mrtbaggins95/SAWS/EAGLE_Stuff/LINK.txt

https://learn.adafruit.com/creating-accurate-footprints-in-eagle/importing-the-bitmap-into-eagle
