mrtbaggins95/SAWS/PCB Design/SAWS Peripheral Schematics_33A1F133-93B0-4803-9BBE-AD26970263C1-1.A.1/Released/SAWS Peripheral Schematics.PDF

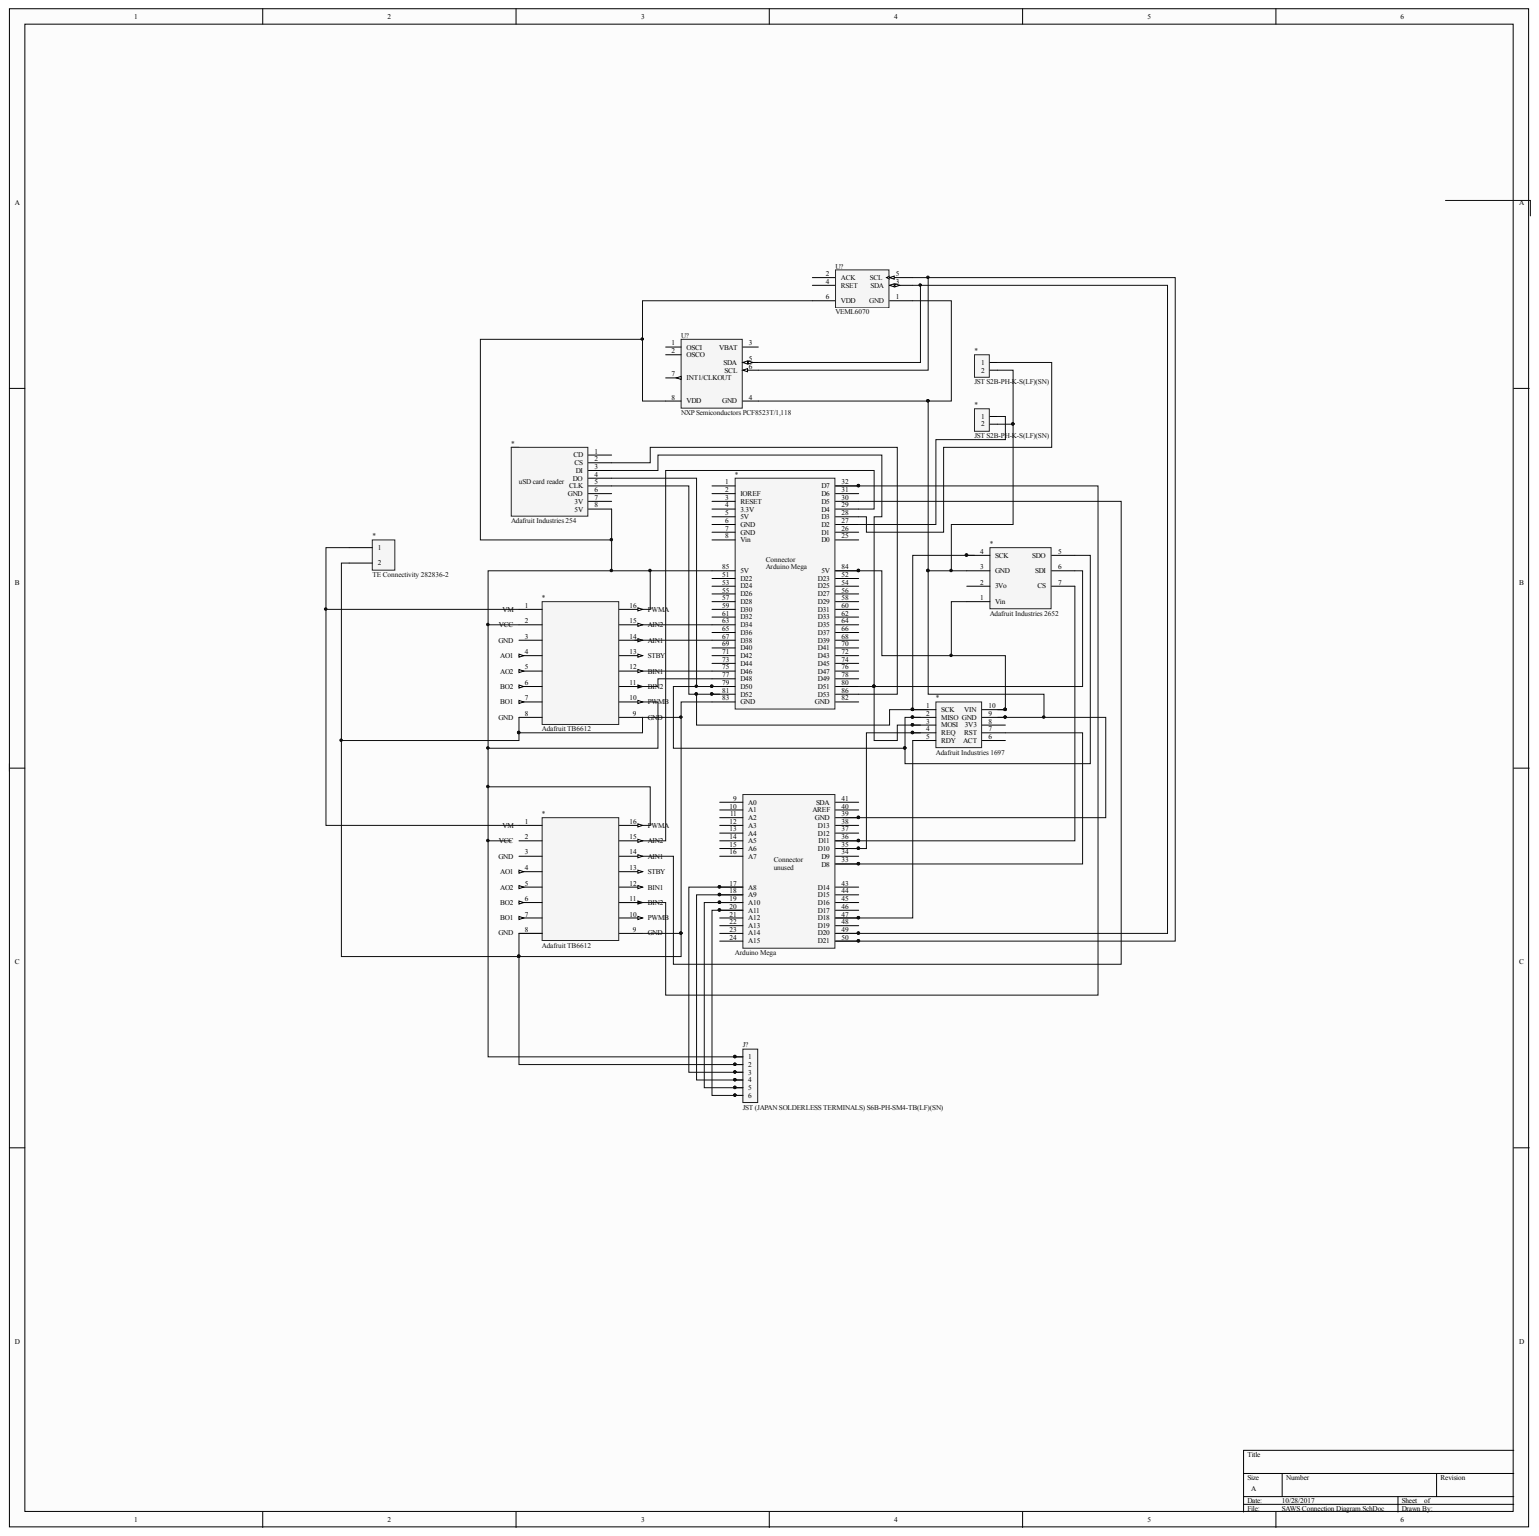
[picture p25: page 1]

PIU?04

VDD 6

GND 3

PI007 | | PI0010 | | | PI0082 | SCK 1

RDY 5 ACT MISO 2 | 6 RST 7 3V3 8 GND 9 VIN 10

PI002 | MOSI 3 | PI009

PI009 | | PI0041 | Adafruit Industries 1697

PI0010 | A1 10 | PI0040
PI0011 | A2 11 | PI0039

VCC | PI001 2 | PI0016 | AIN2 15 | PI0012 PI0012 PI0013 PI0013 | A4 13 | PI0038 PI0038 PI0037 PI0037

Size A | Number | Revision

Date: 10/28/2017 | Sheet of
File: SAWS Connection Diagram.SchDoc | Drawn By:

# Board S
