mrtbaggins95/SAWS/(list of files, drawings)

Other design files:
PCB Design/SAWS Peripheral Schematics_33A1F133-93B0-4803-9BBE-AD26970263C1-1.A.1/Design/SAWS Connection Diagram.SchDoc
PCB Design/SAWS Peripheral Schematics_33A1F133-93B0-4803-9BBE-AD26970263C1-1.A.1/Design/SAWS Peripheral Schematics.PrjPcb
