mrtbaggins95/SAWS/EAGLE_Stuff/Adafruit-PCF8523-RTC-Breakout-PCB-master/Adafruit PCF8523 RTC.brd

## EAGLE design EAGLE_Stuff/Adafruit-PCF8523-RTC-Breakout-PCB-master/Adafruit PCF8523 RTC.brd (2017-12-06)

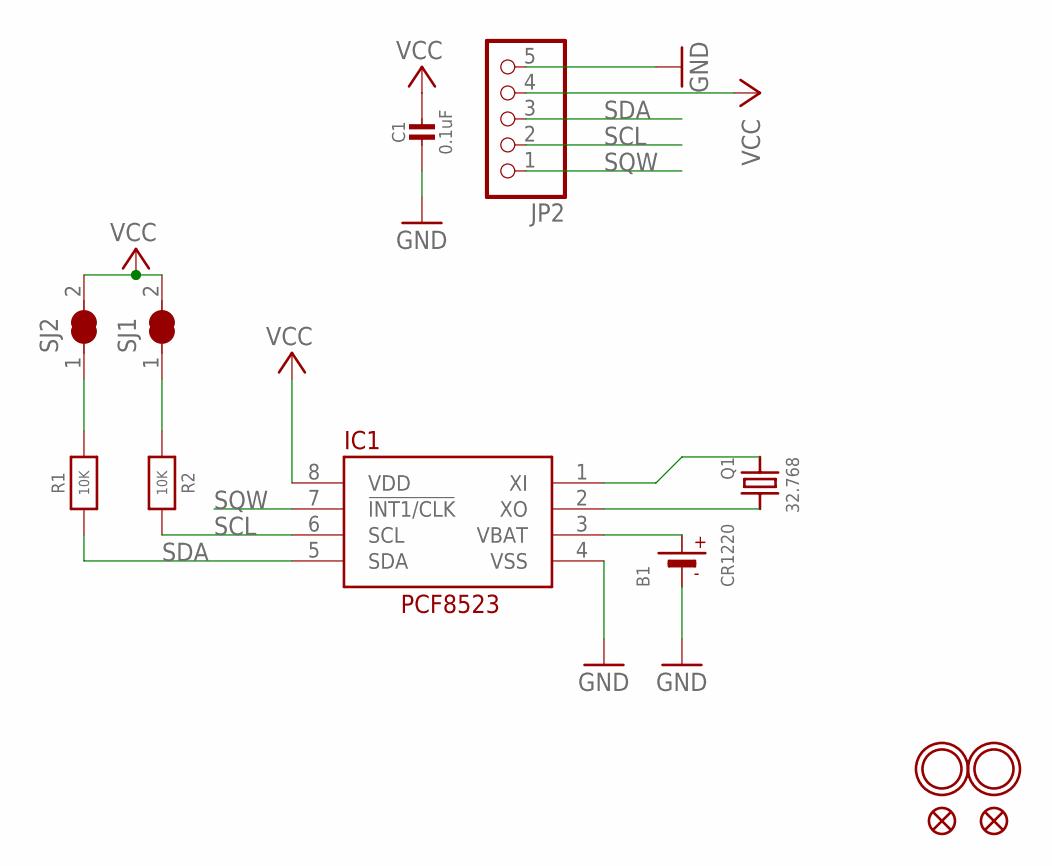
[picture p26: schematic Adafruit PCF8523 RTC.sch]

Parts:
B1: CR1220
C1: 0.1uF; 0805-NO
FID1, FID2: FIDUCIAL""; FIDUCIAL_1MM
IC1: RTC_PCF8523T; SOIC8_150MIL
JP2: HEADER-1X576MIL; 1X05_ROUND_76
Q1: 32.768; CRYSTAL_8X3.8
R1, R2: 10K; 0805-NO
SJ1, SJ2: SOLDERJUMPER_CLOSED; SOLDERJUMPER_CLOSEDWIRE
U$1, U$4: MOUNTINGHOLE2.0; MOUNTINGHOLE_2.0_PLATED

Connections:
GND: B1.-, C1.2, IC1.4 (VSS), JP2.5
unnamed: R2.1, SJ1.1
unnamed: R1.2, SJ2.1
unnamed: IC1.1 (XI), Q1.P$1 (1)
unnamed: IC1.2 (XO), Q1.P$4 (2)
SCL: IC1.6 (SCL), JP2.2, R2.2
SDA: IC1.5 (SDA), JP2.3, R1.1
SQW: IC1.7 (!INT1/CLK), JP2.1
VBAT: B1.+$1 (+), IC1.3 (VBAT)
VCC: C1.1, IC1.8 (VDD), JP2.4, SJ1.2, SJ2.2

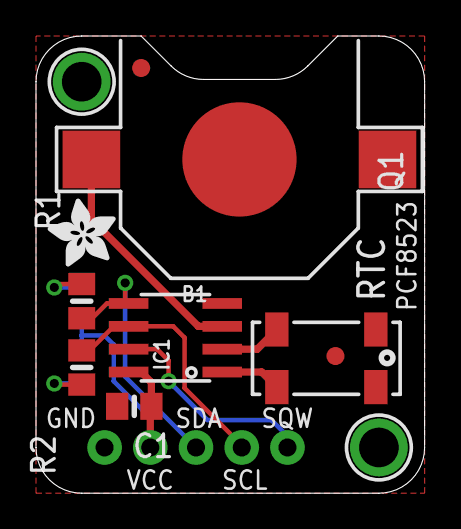
[picture p27: board Adafruit PCF8523 RTC.brd from above]

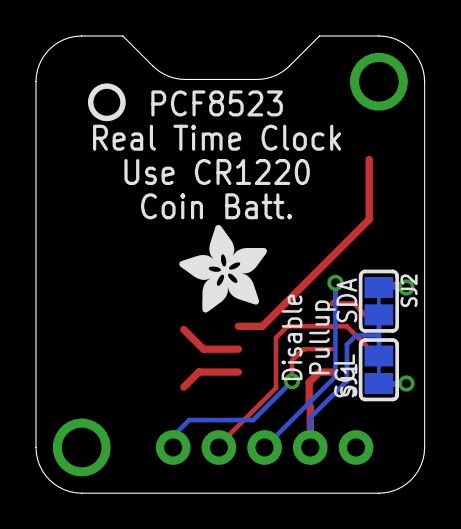
[picture p28: board Adafruit PCF8523 RTC.brd from below]

Board: 2 copper layers, 21.6 x 25.4 mm, 16 parts (4 on the bottom side), 10 nets.

Other parts of the board:
U$2: ADAFRUIT_3.5MM
U$3: PCBFEAT-REV-040
U$5: ADAFRUIT_5MM
