mrtbaggins95/SAWS/EAGLE_Stuff/Adafruit-Bluefruit-LE-nRF8001-PCB-master/Adafruit Bluefruit LE nRF8001.brd

## EAGLE design EAGLE_Stuff/Adafruit-Bluefruit-LE-nRF8001-PCB-master/Adafruit Bluefruit LE nRF8001.brd (2017-12-06)

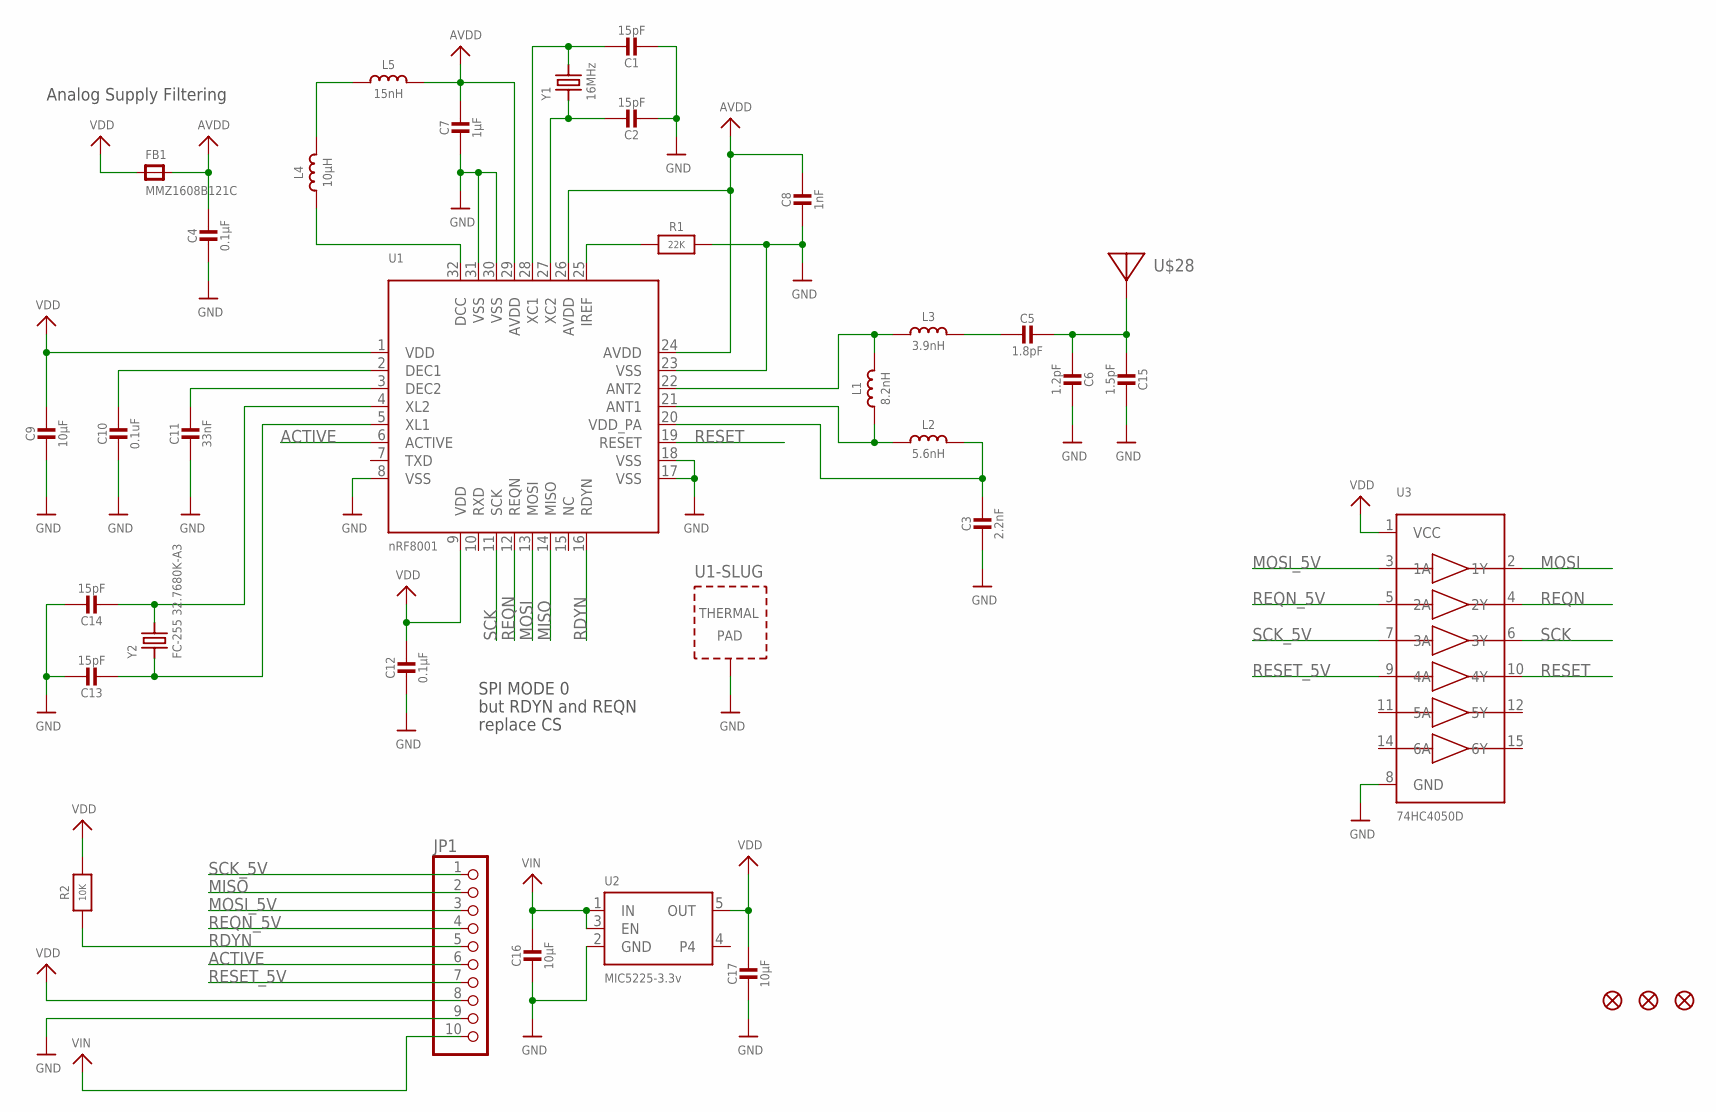
[picture p29: schematic Adafruit Bluefruit LE nRF8001.sch]

Parts:
C1, C2, C13, C14: 15pF; 0805-NO
C3: 2.2nF; _0402
C4, C12: 0.1µF; 0805-NO
C5: 1.8pF; _0402MP
C6: 1.2pF; _0402MP
C7: 1µF; 0805-NO
C8: 1nF; _0603
C9, C16, C17: 10µF; 0805-NO
C10: 0.1uF; 0805-NO
C11: 33nF; 0805-NO
C15: 1.5pF; _0402MP
FB1: MMZ1608B121C; 0805
FID1, FID2, FID3: FIDUCIAL""; FIDUCIAL_1MM
JP1: HEADER-1X1070MIL; 1X10_ROUND70
L1: 8.2nH; _0402
L2: 5.6nH; _0402
L3: 3.9nH; _0402
L4: 10µH; _0603
L5: 15nH; _0603
R1: 22K; _0805MP
R2: 10K; 0805-NO
U1: nRF8001; QFN32_5MM
U2: MIC5225-3.3v; SOT23-5
U3: 74HC4050D; TSSOP16
U$28: ANTENNA_PCBNRF8001_1.6MM; ANT_PCB_2.4GHZ_NRF8001_1.6MM_1OZ
Y1: 16MHz; CRYSTAL_2.5X2
Y2: FC-255 32.7680K-A3; CRYSTAL_4.9X1.8

Connections:
ACTIVE: JP1.6, U1.6 (ACTIVE)
AVDD: C4.1, C7.1, C8.1, FB1.2, L5.2, U1.24 (AVDD), U1.26 (AVDD), U1.29 (AVDD)
GND: C1.2, C2.2, C3.2, C4.2, C6.1, C7.2, C8.2, C9.2, C10.2, C11.2, C12.2, C13.1, C14.1, C15.1, C16.2, C17.2, JP1.9, R1.2, U1.8 (VSS), U1.17 (VSS), U1.18 (VSS), U1.23 (VSS), U1.30 (VSS), U1.31 (VSS), U1.33 (TP), U2.2 (GND), U3.8 (GND)
MISO: JP1.2, U1.14 (MISO)
MOSI: U1.13 (MOSI), U3.2 (1Y)
MOSI_5V: JP1.3, U3.3 (1A)
unnamed: L1.2, L3.1, U1.22 (ANT2)
unnamed: L1.1, L2.1, U1.21 (ANT1)
unnamed: C3.1, L2.2, U1.20 (VDD_PA)
unnamed: L4.2, L5.1
unnamed: C5.2, L3.2
unnamed: C11.1, U1.3 (DEC2)
unnamed: C10.1, U1.2 (DEC1)
unnamed: C1.1, U1.28 (XC1), Y1.3 (2)
unnamed: C2.1, U1.27 (XC2), Y1.1
unnamed: L4.1, U1.32 (DCC)
unnamed: R1.1, U1.25 (IREF)
unnamed: C5.1, C6.2, C15.2, U$28.FEED
unnamed: C14.2, U1.4 (XL2), Y2.2
unnamed: C13.2, U1.5 (XL1), Y2.1
RDYN: JP1.5, R2.1, U1.16 (RDYN)
REQN: U1.12 (REQN), U3.4 (2Y)
REQN_5V: JP1.4, U3.5 (2A)
RESET: U1.19 (RESET), U3.10 (4Y)
RESET_5V: JP1.7, U3.9 (4A)
SCK: U1.11 (SCK), U3.6 (3Y)
SCK_5V: JP1.1, U3.7 (3A)
VDD: C9.1, C12.1, C17.1, FB1.1, JP1.8, R2.2, U1.1 (VDD), U1.9 (VDD), U2.5 (OUT), U3.1 (VCC)
VIN: C16.1, JP1.10, U2.1 (IN), U2.3 (EN)

Notes on the sheet:
Analog Supply Filtering
SPI MODE 0
but RDYN and REQN
replace CS

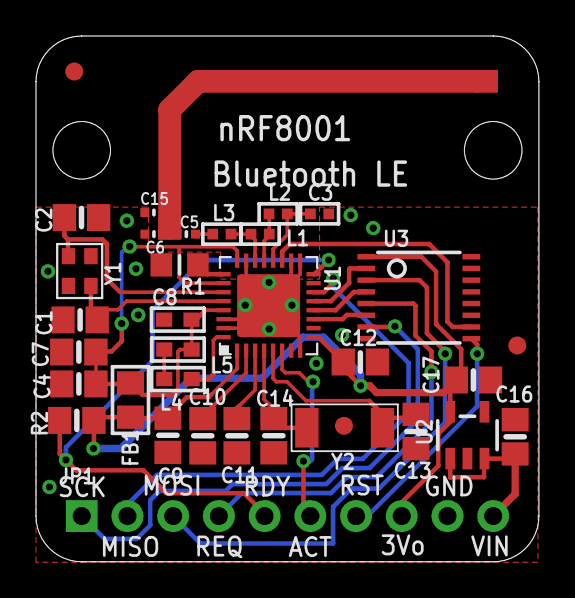
[picture p30: board Adafruit Bluefruit LE nRF8001.brd from above]

Board: 2 copper layers, 27.9 x 29.2 mm, 36 parts (1 on the bottom side), 29 nets.

Other parts of the board:
U$22: ADAFRUIT_TEXT_20MM
