mrtbaggins95/SAWS/EAGLE_Stuff/Adafruit-VEML6070-PCB-master/Adafruit VEML6070.brd

## EAGLE design EAGLE_Stuff/Adafruit-VEML6070-PCB-master/Adafruit VEML6070.brd (2017-12-06)

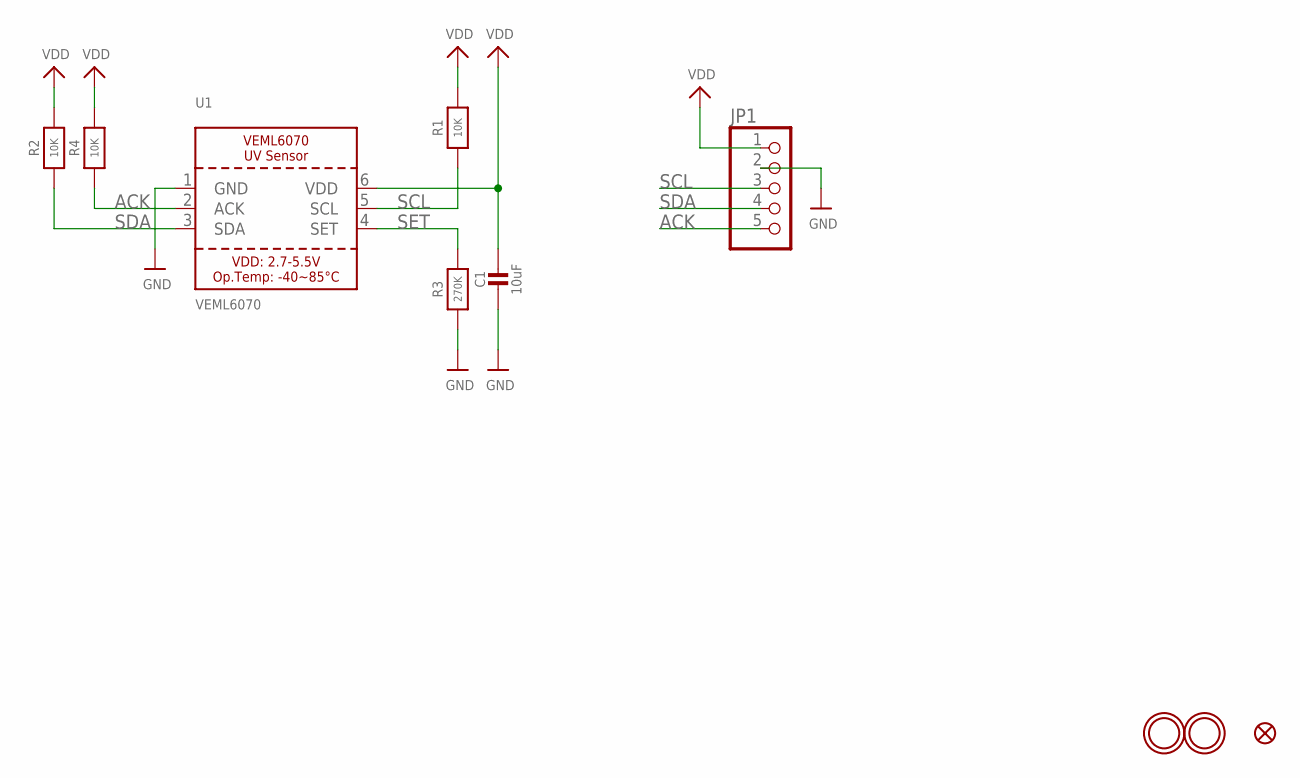
[picture p31: schematic Adafruit VEML6070.sch]

Parts:
C1: 10uF; 0805-NO
FID1: FIDUCIAL""; FIDUCIAL_1MM
JP1: HEADER-1X570MIL; 1X05_ROUND_70
R1, R2, R4: 10K; 0805-NO
R3: 270K; 0805-NO
U1: VEML6070
U$10, U$11: MOUNTINGHOLE2.5; MOUNTINGHOLE_2.5_PLATED

Connections:
ACK: JP1.5, R4.1, U1.2 (ACK)
GND: C1.2, JP1.2, R3.1, U1.1 (GND)
SCL: JP1.3, R1.1, U1.5 (SCL)
SDA: JP1.4, R2.1, U1.3 (SDA)
SET: R3.2, U1.4 (SET)
VDD: C1.1, JP1.1, R1.2, R2.2, R4.2, U1.6 (VDD)

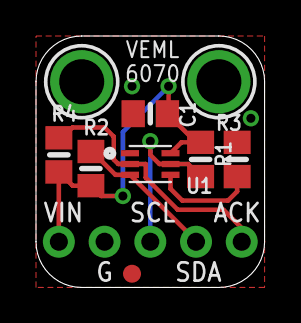
[picture p32: board Adafruit VEML6070.brd from above]

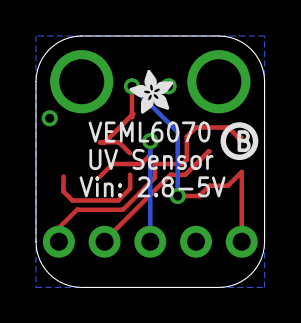
[picture p33: board Adafruit VEML6070.brd from below]

Board: 2 copper layers, 12.7 x 14.0 mm, 12 parts (2 on the bottom side), 6 nets.

Other parts of the board:
U$2: PCBFEAT-REV-040
U$14: ADAFRUIT_2.5MM
