mrtbaggins95/SAWS/EAGLE_Stuff/Adafruit-BMP280-Breakout-PCB-master/Adafruit BMP280.brd

## EAGLE design EAGLE_Stuff/Adafruit-BMP280-Breakout-PCB-master/Adafruit BMP280.brd (2017-12-06)


Parts:
C1, C3: 10uF; 0805-NO
D2: 1N4148; SOD-323
JP2: HEADER-1X770MIL; 1X07_ROUND_70
Q3, Q4: BSS138; SOT23-WIDE
R1, R2, R7, R8: 10K; 0805-NO
R4: 10K; _0805MP
U1: BME280
U2: MIC5225-3.3; SOT23-5
U$5, U$15: FIDUCIAL""; FIDUCIAL_1MM
U$7, U$8: MOUNTINGHOLE2.0; MOUNTINGHOLE_2.0_PLATED

Connections:
3.3V: C3.1, JP2.2, Q3.1 (G), Q4.1 (G), R1.2, R2.2, R4.2, U1.6 (VDDIO), U1.8 (VDD), U2.5 (OUT)
5.0V: C1.1, JP2.1, R7.2, R8.2, U2.1 (IN), U2.3 (EN)
CS_3V: D2.A, U1.2 (CSB)
CS_5V: D2.C, JP2.7
GND: C1.2, C3.2, JP2.3, U1.1 (GND), U1.7 (GND), U2.2 (GND)
SCK/SCL_5V: JP2.4, Q3.3 (D), R7.1
SCK_3V: Q3.2 (S), R2.1, U1.4 (SCK)
SDI/SDA_5V: JP2.6, Q4.3 (D), R8.1
SDI_3V: Q4.2 (S), R1.1, U1.3 (SDI)
SDO/ADR_3V: JP2.5, R4.1, U1.5 (SDO)

Notes on the sheet:
For SPI set CSB low at startup SDO=MISO, SDI=MOSI, SCK=SCK, CSB=CS/SSEL
For I2C leave CSB pulled high (default value) SDI=SDA, SCK=SCL
LEVEL SHIFTING (5V <--> 3V)

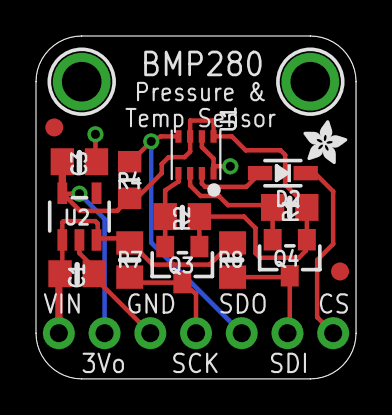
[picture p35: board Adafruit BMP280.brd from above]

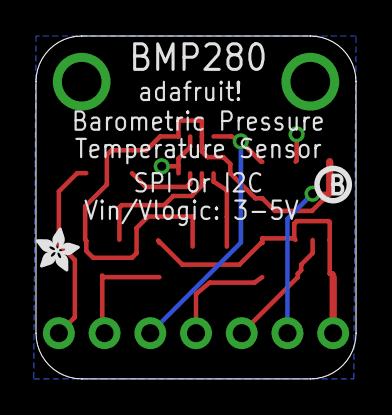
[picture p36: board Adafruit BMP280.brd from below]

Board: 2 copper layers, 17.8 x 19.1 mm, 20 parts (2 on the bottom side), 10 nets.

Other parts of the board:
U$2, U$6: ADAFRUIT_2.5MM
U$20: PCBFEAT-REV-040
