mrtbaggins95/SAWS/EAGLE_Stuff/MicroSD-breakout-board-master/microsd.brd

## EAGLE design EAGLE_Stuff/MicroSD-breakout-board-master/microsd.brd (2017-12-06)


Parts:
ACT: RED; CHIP-LED0805
C1: 10uF/10V; A/3216-18R
C2: 0.1uF; C0805K
IC1: 4050D; SO16
IC2: LP298XS; SOT23-5L
JP1: PINHD-1X8BIG; 1X08-BIG
R1: 1K; R0805
U$1, U$2: FIDUCIAL; FIDUCIAL_1MM
X1: MICROSD

Connections:
+3V3: C1.+, IC1.1 (VDD), IC2.5 (VOUT), JP1.2, X1.4 (VDD)
CD: JP1.8, X1.CD1 (CARD_DETECT)
CLK: IC1.3 (I), IC1.9 (I), JP1.4
CS: IC1.7 (I), JP1.7
DI: IC1.5 (I), JP1.6
DO: JP1.5, X1.7 (DATA_OUT)
GND: C1.-, C2.2, IC1.8 (VSS), IC1.11 (I), IC1.14 (I), IC2.2 (GND), JP1.3, X1.6 (VSS), X1.MT1 (GND), X1.MT2 (GND1)
unnamed: ACT.A, IC1.10 (O)
unnamed: IC1.2 (O), X1.5 (SCLK)
unnamed: IC1.6 (O), R1.1, X1.2 (CS)
unnamed: ACT.C, R1.2
unnamed: IC1.4 (O), X1.3 (DATA_IN)
VCC: C2.1, IC2.1 (VIN), IC2.3 (EN), JP1.1


Board: 2 copper layers, 31.8 x 25.4 mm, 10 parts (0 on the bottom side), 13 nets.
