mrtbaggins95/SAWS/HomeStepper_Test2/HomeStepper_Test2.ino

/* James Donahue
    10/22/17
    SAWS Fall 2017 Senior Design Project
    ***********************************************************
    THIS PROGRAM DEMONSTRATES HOME STEPPER AS WELL AS A FUNCTION TO MOVE THE SERVO TO A SPECIFIC ANGLE, WHILE UPDATING OUR ANGLE NUMBER
    This sketch demonstrates the use of a stepper home function. The program needs to keep track of the current position of the gantry.
    Since we are using bipolar stepper motors, we must calibrate the stepper position, with the virtual program position. 3D printers
    use home switches that close when the stepper motor hits a known position. This program uses interrupts to detect when the a normally open
    homing switch closes.
*/

int baseAngle;
#include <Stepper.h>
volatile int Home = false; // variable that is modified by the Interrupt, on pin 2. Needs to be global

void setup() {
  attachInterrupt(digitalPinToInterrupt(2), pin_ISR, LOW); // Defining an active low interrupt on the switch pin 2
  Serial.begin(9600);
  HomeStepper();
}

void loop() {
  if (Serial.available()) {
    int degree = Serial.parseInt();
    delay(10);
    if (degree < 0 || degree > 300) // limits set by machine
    {
      Serial.println(" Invalid Angle");
    }
    else
    {
      MoveStepper(degree); // function that moves stepper to a desired angle
    }

  }

  void HomeStepper() {
#define STBY 8 // Pull this pin low to completely cut off power to the stepper
#define STEPS 200 // Number of steps per rotation, this is specific to our motor
#define HomeSwitch 2
    Stepper stepper(STEPS, 4, 5, 6, 7); // creates a stepper object called stepper, using pins 4-7
    stepper.setSpeed(100); // sets the speed of the motor in rpm
    pinMode(STBY, OUTPUT);
    digitalWrite(STBY, HIGH);
    pinMode(HomeSwitch, INPUT_PULLUP); //sets the HomeSwitch pin(2) as an input that uses internall pull ups
    while (Home == false) { //This while loop continue to step the motor, while the swith is open(high)
      stepper.step(1); // steps the motor once
    }
    baseAngle = 0; // Now that we have homed, set the angle to zero.
    digitalWrite(STBY, LOW); // puts motor driver into standby
  }

  void pin_ISR() { // this is the interrupt service routine. Basically the function that happens when interrupt occurs
    Home = true; // update the home variable to exit the while loop.
  }

  void MoveStepper() {
    Stepper stepper(STEPS, 4, 5, 6, 7); // creates a stepper object called stepper, using pins 4-7
    stepper.setSpeed(100); // sets the speed of the motor in rpm
    float degPerStep = 1.8;
    int deltaSteps = (degree - baseAngle) / degPerStep;
    stepper.step(deltaSteps);
    baseAngle = degree; // update the virtual position variable after the stepper has moved
  }
