mrtbaggins95/SAWS/(commit log)

2017-10-07 Bluetooth and Sensor
    Attempted to transmit sensor serial monitor data to bluetooth
2017-10-08 bluetooth serial print
    interfaced the sensor data to print on the bluetooth connected device?
2017-10-09 Initial Commit
    Schematic includes traces between the Mega, BME280, and nrf80001.
    [SAWS Connection Diagram.SchDoc]
2017-10-17 Stepper adapted sweepSun
2017-10-21 Typo correction on SweepSun();
    [sweepSun_servo0.ino]
2017-10-22 This program demonstrates the use of the HomeStepper() function.
    HomeStepper only needs to be called once to function. This program contains two functions, HomeStepper() and pin_ISR(). pin_ISR() is an interrupt service routine. HOMESTEPPER USES INTERRUPTS BE CAREFULL WITH THIS. Both functions must be placed within the main program for this functionality to work. Also note that the stepper library must be included and that the variable Home must a globally define variable.
2017-10-23 coded base files for stepper commands
2017-10-23 Added Modulo correction to trackSun Stepper
    [HomeStepper_Test.ino, trackerSun_stepper.ino]
2017-10-28 Circuitmaker Schematic
    It's done
    [SAWS Connection Diagram.SchDoc]
2017-10-29 power results
    added the power components of our system. added a power flow diagram
    [BOM_PartType-SAWS Peripheral Schematics.xls, SAWS Connection Diagram.SchDoc, SAWS Peripheral Schematics.PrjPcb]
2017-11-01 added new slide for power results ppt
    included a new slide with pictures and included the measured readings from the panel
2017-11-01 power slides update
    updated power flow diagram to include bluetooth transceiver and the data storage
2017-11-29 11/29/17 update
    uploaded the library of the uv sensor
    uploaded the test code for uv sensor (still trying to figure out the ranges of the intensity reading)
    updated hub result presentation slides: the hub, issues encountered, solutions, and in progress
    [veml6070_test.ino]
2017-11-29 error free (so far) cpp and h for STA
    [sunFunctions.cpp]
2017-12-06 uv sensor code
    updated the code to output an UV index reading ie, Extreme, Very High, High, Moderate, Low
2017-12-06 CRAP
    CRAP from my attempts to use eagle.
    [Adafruit BMP280.brd, Adafruit BMP280.sch, Adafruit Bluefruit LE nRF8001 v2.brd, Adafruit Bluefruit LE nRF8001 v2.sch, Adafruit Bluefruit LE nRF8001.brd, Adafruit Bluefruit LE nRF8001.sch, Adafruit PCF8523 RTC.brd, Adafruit PCF8523 RTC.sch]
2017-12-07 uv sensor 12/6 update
    fixed the reading = uv.readUV declaration
    changed the print output from values to UV index
    [veml6070_test.ino]
2017-12-09 12/8-9/17 update
    incorporated UV sensor (VEML6070) to the BLE-BME code
2017-12-10 new BLE/BME code (v5)
    prints out values and readings to uart
2017-12-10 12/9/17 18:57 update for bme/nrf8001
    changed from software spi to hardware spi
2017-12-11 Revert "Version 0 established, Master Directory"
    [solar_tracker_code.ino, sweepSun_pseudocode.ino, sweepSun_servo.ino, trackSun_servo.ino]
2017-12-15 EVERYTHING WORKS
    Until we upload to arduino...
    Use BlynkSensorOutput to test data function
    Use Quadsensor to test sun tracking and movement
2017-12-17 Changes have been made in order to try and fix SweepSun to work with our hardware. SWEEP SUN DOES NOT WORK. GARRET PLEASE DONT TEST THIS ON OUR HARDWARE WITHOUT JORDAN OR I PRESENT.
    [HomeStepper_Test.ino, _400D_AzimuthTest1.ino, sweepSun_stepper.ino, trackerSun_stepper.ino]
2017-12-17 consolidated code
    moved sensor only code to sensor only folder
    sensor with bluetooth, separate folder
    uploaded bme & uv serial monitor code
2017-12-17 James Added the SD card functionallity
    [BlynkSensorOutput.ino]
2017-12-18 Final Changes, Everything worked okay. Except for the "Burst Issue"
    [BlynkSensorOutput.ino, _400D_FinalCode.ino, trackerSun_stepper.ino]
